lawrencek52/CPU1-NRF5340-uBlox-NORA/Bittele_Initial_DFM_Check_Report_8030233A1_20250904_LJK.xlsx

Sheet: DFM
 |  |  | Initial Design for Manufacturing Check Report |  |  |  |  |  |  |  | Form No:
 |  |  |  |  |  |  |  |  |  |  | BTL-DFM-001
Product # |  | Customer ID |  | Purchase Order | Quantity | Checked by |  |  | Audit by
 |  |  |  |  |  | Name | Date | Time(Hour) | Name | Date
8030233A1 |  | 503097 |  | None | 5 | Nate | 2025-09-04
Gerber File |  | R |  | X-Y Coordinate File | □ | Drill File | R | BOM check |  | Others
Note: If you have BOM change requests, please send the list of change details instead of sending an updated(new) BOM for quick turnaround. We will ignore the BOM in any zip file unless being requested.
Quiz# | Question Description |  |  |  |  | Illustration |  |  |  |  | Client Reply
DFM#1 | We found in the '*.gbrjob' file final board thickness is 1.0mm, but the order release file mentioned final board thickness is 1.2mm(47mil). You have specified the thickness of dielectric between layers, we will need to get it adjusted to meet our material sourcing and fabrication requirements. Suggestion A: Final board thickness as 1.0mm+/-10%, Allow us to adjust the stackup and our stack up in "Stackup A" is OK. Suggestion B: Final board thickness as 1.2mm(47mil)+/-10%, Allow us to adjust the stackup and our stack up in "Stackup B" is OK. |  |  |  |  |  |  |  |  |  | I initially started out targetingt 1mm thickness, however another supplier suggested 1.2mm would work for his in-stock materials. I prefer a 1mm thick PCB, please continue with 1.0mm. There are no impedance critical traces on this PCB, Any stackup that uses your standard materials is good. 1oz copper all layers is preferred. Use Stackup A.
DFM#2 | We found in the '*.gbrjob' file PCB size is 50.05x30.05mm, but the real PCB size is 50.0x30.0mm measured in Gerber file. Suggestion: Follow Gerber file for size of board. |  |  |  |  |  |  |  |  |  | I have no idea why KiCad, gives two different measurements. 50.0x30.0mm is the intended size.
DFM#3 | We found in the '*.gbrjob' file silkscreen green, but in the order release file, silkscreen white. Suggestion: Silkscreen white. |  |  |  |  |  |  |  |  |  | I prefer White.
DFM#4 | We found in the '*.gbrjob' file, it showed copper L7, L9, L11, but this is 6-layer board. and the layer sequence is not defined in Gerber. Please clarify. Suggestion: This is 6-layer board, we will build the layer sequence from top to bottom as shown in the picture on the right. |  |  |  |  |  |  |  |  |  | Correct this is a 6-layer board. I have no idea why KiCAD added the other layers. Prefered stacking order is to have PWR and GND on L2 and L5, with in1 and in2 between. However this is not critical.
DFM#5 | The copper area of the in1/in2 and pwr/gnd differs by more than 70%, which cause the stackup is asymmetrical, and it caused the board bow and twist exceed 0.75% and affect our assemble. In order to avoid this problem, we suggest we can add dummy copper pad in in1/in2, and keep the spacing from all existing copper 50mil. Suggestion : Allow us to add dummy copper pad in in1/in2. |  |  |  |  |  |  |  |  |  | Yes you can add dummy copper pad/pour in the inner layers to balance the copper. I suggested above moving the PWR and GND planes to L2 and L5, I think this will also balance the stresses. Either way is fine for me.
DFM#6 | The spacing is only 5.4mil between trace and NPTH hole. It is not enough for us. Suggestion: We can move the trace away from NPTH hole to gain 8mil spacing. (we can edit it on our side) |  |  |  |  |  |  |  |  |  | I will add this to my design rules for the next board. OK to move the track.
DFM#7 | Some via holes (0.2mm) with solder mask opening are close to the SMD pads as the picture shown for example, which will affect our assembling process, we would like to delete the solder mask opening of all via holes on both sides to smooth our assembling process. Suggestion A: Delete the solder mask opening for all via holes (0.2mm) on both sides, and only keep the solder mask opening of the via holes which on thermal pads. Suggestion B: Reducing the solder mask openings bigger than via holes 4mils(0.1mm) per side for all via holes (0.2mm). |  |  |  |  |  |  |  |  |  | Yes the board was a little congested and I ended up with Vias nibbling into pads. Please feel free to adjust the solder mask to make it work with your process. Solder mask is not critical to the design. Opening all vias, or only the vias with issues is OK either way. Do you need me to make this change?
DFM#8 | On the bottom side, the silkscreen is not match the pad, it looks more like top silkscreen layer, the components are on top side. Suggestion A: Ignore the bottom silkscreen layer, no silkscreen on bottom side of board. Suggestion B: Send us the new Gerber, put these silkscreen on top side (no mirror them), and if they are on or near pads, we can clip it from exposed pad, fuzzy and incomplete legends will be acceptable. |  |  |  |  |  |  |  |  |  | yes, this is correct. Reference designators on the backside of the PCB
DFM#9 | The spacing is only 11mil between non-plated hole and board edge, it may be broke after routing. Suggestion: The two holes break at board edge is acceptable. |  |  |  |  |  |  |  |  |  | Yes unfortunately the switches need to be close to the edge so that a human can press the buttons. If break occurs this is OK.

Sheet: 2nd
 |  |  | Initial Design for Manufacturing Check Report |  |  |  |  |  |  |  | Form No:
 |  |  |  |  |  |  |  |  |  |  | BTL-DFM-001
Product # |  | Customer ID |  | Purchase Order | Quantity | Checked by |  |  | Audit by
 |  |  |  |  |  | Name | Date | Time(Hour) | Name | Date
8030233A1 |  | 503097 |  | None | 5 | Nate
Gerber File |  | R |  | X-Y Coordinate File | □ | Drill File | R | BOM check |  | Others
Note: If you have BOM change requests, please send the list of change details instead of sending an updated(new) BOM for quick turnaround. We will ignore the BOM in any zip file unless being requested.
Quiz# | Question Description |  |  |  |  | Illustration |  |  |  |  | Client Reply
DFM#1
DFM#2
DFM#3

Sheet: 3rd
 |  |  | Initial Design for Manufacturing Check Report |  |  |  |  |  |  |  | Form No:
 |  |  |  |  |  |  |  |  |  |  | BTL-DFM-001
Product # |  | Customer ID |  | Purchase Order | Quantity | Checked by |  |  | Audit by
 |  |  |  |  |  | Name | Date | Time(Hour) | Name | Date
8030233A1 |  | 503097 |  | None | 5 | Nate
Gerber File |  | R |  | X-Y Coordinate File | □ | Drill File | R | BOM check |  | Others
Note: If you have BOM change requests, please send the list of change details instead of sending an updated(new) BOM for quick turnaround. We will ignore the BOM in any zip file unless being requested.
Quiz# | Question Description |  |  |  |  | Illustration |  |  |  |  | Client Reply
DFM#1
DFM#2
DFM#3

Sheet: Sheet1
资料相同-ODB | 2份PDF | 二维码 | 忽略IPC356 | 圆角-Slot | 成品板厚含绿油 | 板材 | TBD | TBD | TBD | TBD | TBD | ENIG
层顺序 | 图形一致 | Dummy PAD | 外形削铜 | 外层Hoz | 铜厚公差 | 线和PAD没连好 | TBD | TBD | VIP | Dam | 油墨入孔 | 虹吸
层压 | 共面影响 | ZK没有参考 | ZK间距不一致 | 参考铜皮不完整 | 同时满足2种阻抗 | TBD | 拼板 | 字符 | 白油桥 | Lot code | 不加stamp | 中国制造 | 小数点问题
资料相同 | The two zip files provided by you both including Gerber files, ODB++ files, and drawings. It is difficult for us to verify and compare them one by one to check if they are the same. Please confirm if they are identical, so I can use either one to produce the PCB. Suggestion: They are identical, we can use either one to produce the PCB. ########### 有解压的和未解压的 The given data include two files, one extracted and one not, containing a total of three Gerber files. It is difficult for us to check them one by one. Please confirm if they are the same, and we can use any one of the Gerber files. Suggestion: They are the same, and we can use any one of the Gerber files. ########### 只有ODB++ We were only provided with the ODB++ file. Since this type of file often contains some hidden errors, we prefer to use the more stable Gerber274x files." Suggestion: Provide us the Gerber274x file, ODB++ file just for reference.
层序 | The layer sequence is not defined in Gerber. Please clarify. Suggestion: We will build the layer sequence from top to bottom as shown in the picture on the right.
外形削铜 | ###### 铜皮无间隙 There is no clearance between copper plane and board edge on both side, it will be copper exposed after routing. we need 10mil clearance to avoid copper exposed issues. Suggestion: Shaving copper plane to gain 10mil clearance to avoid copper exposed issues on both side. ###### 铜皮间隙 The clearance is 2.5mil between copper plane and board edge on both side, it will be copper exposed after routing. we need 10mil clearance to avoid copper exposed issues. Suggestion: Shaving copper plane to gain 10mil clearance to avoid copper exposed issues on both side. ####### PAD到板边 There is no clearance between the edge of pad and board edge on both side, it will be copper exposed after routing. we need 10mil clearance to avoid copper exposed issues. Suggestion A: Shaving pads to gain 10mil clearance to avoid copper exposed issues on both side. Suggestion B: Follow Gerber file, copper exposed issue is acceptable on both side.
图形一致 | G1 and G2 layers are of the same copper pattern as the picture shown, please confirm they are the same. Suggestion: G1 layer as the same as G2 layer, just follow Gerber file.
虹吸 | ################## 只删除这些指出的孔 Some via holes( ) with solder mask opening are close to the SMD pads as the picture shown, which will affect our assembling process, we would like to delete the solder mask opening of these holes on both sides to smooth our assembling process. Suggestion A: Delete the solder mask openings of these via holes (indicated in the picture) on both sides. Suggestion B: Reducing the solder mask openings bigger than via holes 3mils(0.08mm) per side for these holes (indicated in the picture). ################## 删除所有的孔 Some via holes( ) with solder mask opening are close to the SMD pads as the picture shown for example, which will affect our assembling process, we would like to delete the solder mask opening of all via holes on both sides to smooth our assembling process. Suggestion A: Delete the solder mask opening for all via holes( ) on both sides, and only keep the solder mask opening of the via holes which on thermal pads. （注意检查是否有散热盘） Suggestion B: Reducing the solder mask openings bigger than via holes 3mils(0.08mm) per side for all via holes ( ).
油墨入孔 | ########### 油墨入孔 如果是 喷锡板 只给一个加开窗的建议 As the picture shown, these 25mils holes without solder mask opening on both side, the solder mask ink may flow into the hole, causing the solder ball to be trapped in the hole and unable to come out. However, during our assembling process, the trapped solder ball in the hole may pop out, leading to unnecessary short circuits. Suggestion: Adding solder mask opening bigger than hole 4mil per side for these holes on both side to avoid this risk. ############### As the picture shown, please confirm these big holes (25mil, 35mil and 50mil) are via holes or not? and due to they are without solder mask opening on both side, the solder mask ink will flow into the hole is acceptable or not? Suggestion A: Follow Gerber, and solder mask ink flow into these holes are acceptable. Suggestion B: Adding solder mask opening bigger than hole 4mil per side for these holes on both side to avoid solder mask ink flow into hole.
桥 | As shown in the picture , you have designed solder mask dam between SMD pads, but the spacing is 5.7mils between those pads, it hard to keep the solder mask dam for us, we need the minimum 7mils spacing for 1oz copper weight. If there is no solder mask dam between pads, it is easy for solder bridge issues to occur between pads during assembly, to help the assembly process, we are wondering if we can shave SMD pads a little or use solder mask define pad to keep the solder mask dam between the pads. Suggestion A: Shaving those SMD pads to gain 7mils spacing between SMD pads is acceptable. Suggestion B: Enlarge the copper pads and reduce the solder mask opening in such places to build the solder mask dam. And finally, the SMD pads will be covered by solder mask a little, but the exposed area will be almost the same as the original pad size. ########## 削中间大PAD You have designed solder mask dam between SMD pads and the big central pad, but the spacing is 5.5mils between those pads, it hard to keep the solder mask dam for us, we need the minimum 7mils spacing for 1oz copper. Suggestion: Shaving the big central pad to gain 7mils spacing to SMD pads is acceptable. ########## 削角落的PAD You have designed solder mask dam between SMD pads, but at the corners the spacing is only 7.2mil between SMD pads, we need the minimum 8mils spacing for blue solder mask. Suggestion: Shaving the SMD pads a little at the corners to gain 8mils spacing to keep the solder mask dam is acceptable.
层压 | ################### 层压结构与客户是一样的， 只是客户的厚度为理论厚度 You have specified the thickness of dielectric between layers, the dielectric thickness in your stackup seems to be the theoretical thickness, while the dielectric thickness in our suggested stackup is the actual thickness after lamination, so there will be a slight difference. In fact, our suggested stackup is the same as the one you provided. Suggestion: Allow our stack up in "Stackup II" . ################### 层压结构 You have specified the thickness of dielectric between layers, we will need to get it adjusted to meet our material sourcing and fabrication requirements. Suggestion: Allow us to adjust the stackup and our stack up in "Stackup II" is OK. ################### 只有阻抗没有指定层压结构 Due to the board with impedance control, we will design the layer stackup to meet our material sourcing and adjust the width of transmission trace a little to meet the impedance requirements. Suggestion: The stackup as "Stackup II" and adjust the transmission traces as "Figure III" are OK. ####################有阻抗 且 指定层压结构 You have specified the thickness of dielectric between layers, we will need to get it adjusted to meet our material sourcing and to meet the impedance requirements. Suggestion: Adjust the stackup as "Stackup II" and adjust the impedance traces as "Figure III" are OK.
字符 | Some legends are onto or near pad as the picture shown (just to show a few things), and it is not easy to move it away. Suggestion: Clipping any legends from all exposed copper, fuzzy and incomplete legends will be acceptable. ##################### Some legends height is only 20mil, when the legends height smaller than 30mil in Gerber, it will be hard for us to print them clearly, and it is very hard for us to enlarge the legends height from 20mil to 30mil, and some legends are on and near pads. Suggestion: The legends height keep the same as Gerber file, and clip the legends from all exposed copper, fuzzy and incomplete legends will be acceptable.
板材 | You required the material is FR406 in "Fab Files 41-0096-002.PDF", but in order release file mention materials FR4(TG150). And the point is that FR406 (ISOLA) is not a material in common usage in our company. Suggestion: Use our standard FR4(Tg150) material for this board per IPC 4101. Suggestion: Use our standard FR4(Tg170) material for this board per IPC 4101. ############# 忽略DK Note#7 required the dielectric for prepreg and core layers to be 4.3+/-0.2, it is hard to test this for PCB manufacturer. Suggestion: The dielectric of prepreg and core are depend on the material, ignore the requirement of note#7.
二维码 Data matrix | In the order release file, note2 CFT required applying data matrix seriallzation using silkscreen printing onto board, but there is no format of serial number, we are not sure if we can started from 001, and incrementing. If we print the serial number in the silkscreen layer, it will be extra cost, please take note that, if use a sticker to stick the serial number after assemble process, there will be no extra cost. Suggestion A：The serial number is started from 001, and incrementing, use a sticker to stick the serial number after assemble process Suggestion B：The serial number is started from 001, and incrementing, print the serial number in the silkscreen layer, it will be extra cost.
忽略IPC | There are two shorted issues after comparing with netlist file. Suggestion: Ignore the shorted issues, and extract the netlist from the Gerber file to test the physical board is OK. Note#15 required tested for opens and shorts against net list, but we did not get the useful netlist file, there is a *.NET file in the given data, but this is not IPC-356 format, our CAM system can recognize IPC-356 file only. Suggestion: Skip Note#15, extract the netlist from the Gerber file to test the physical board is OK.
圆角 Slot | ############# 内角 We found some internal corners with no radius as the picture shown, due to the board method by routing, and the minimum tool is 40mils, this is means that any internal corner will have a minimum radius of 20mils. Suggestion: Round off all internal corners with a minimum radius of 20mils as "Picture II" is acceptable. ######## Full rounded ends ######### For the 6 slots (1.0x3.23mm), you rounded the four corners with radius 0.4mm, we are wondering if we make them with full rounded ends for drilling process. Suggestion: Full rounded ends for the 6 slots as the "Picture II" is OK. ############# 方孔圆角 The one of drill file name is "RectHoles", but it is not rectangle shape in the NC drill file, they are full rounded ends. Suggestion: The three slots with full rounded ends is OK, just follow NC drill file. ############# 方孔圆角 The T6 and T13 hole type is "Rectangle", but it is not rectangle shape in the NC drill file, they are full rounded ends. Suggestion: The three slots with full rounded ends is OK, just follow NC drill file. ########### 最小 slot 0.5mm The two plated slots width is 0.4mm only (length is 0.9mm), usually, we will oversize the drill 0.1mm to account for the thickness of the plating, so, we have to use 0.5mm drill bit for them, but the minimum drill bit is 0.6mm for slot in PCB industry, so we just can make 0.5mm plated slot. Suggestion: Finished size as 0.5x1.0mm for the 2 slots is OK. The two slots size is 0.45x0.65mm, we have to use 0.55mm slot dr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
VIP | ######### 缩小孔 As the picture shown, we found one 12mils hole on SMD pad, if follow Gerber to build, there will be a risk of leaking tin when assembling and cause a bad effect, so we would like to reduce this via hole size from 12mils to 8mils to reduce the risk. Suggestion: Reduce the via hole size from 12mils to 8mils to reduce the risk. ########## 移孔 There is no via-in-pad requirement for the board, but we found three 13mils via holes in the pad as the picture shown on top side. Is there any way to move the three via holes away SMD pads on your side to avoid via-in-pad design to reduce the cost and lead time. Suggestion: Update the Gerber to us with no via-in-pad design. ############### 做VIP As the picture show, we found some via(0.21mm, 0.35mm) holes in the SMD pads, but there is no via-in-pad requirement in the given data. Suggestion: Do via-in-pad for this board, fill these vias which on the SMD pads with non-conductive resin and plated over, we may requote for via in pad process.
拼板 | You have designed the panel drawing, but this is a turnkey order ( this board will be assembled by our side), so we are not sure if we need to ship it as the single unit board or panel after assembling. Suggestion: Allow us to do panel by ourselves （no confirmation needed), ship it as single unit board after assembling. ######### 套板 ########## 2种不同的板 There are two different boards in the given data, due to this is a turnkey order ( this board will be assembled by our side). Please confirm whether we need to deliver in single or deliver as panels after assembling. Suggestion: We panelize both boards onto one panel by ourselves for assembling, and deliver PCB as single units after assembling. ###### 套板, 确认出板数 There are two different boards per your design, therefore, please confirm the quantity, is it 500 pcs per each board? Suggestion: Yes, 500 pcs per each board. ###### 套板, 确认单板尺寸
共面影响 | These transmission traces to the copper plane spacing is only 5.24mil, it will affect the impedance value about 7 ohms, we advise to trim the copper plane to keep 10mil spacing to impedance trace. Suggestion: Trim the copper plane to keep 10mil spacing to transmission traces (see the "Figure II").
成品板厚含绿油 | Since you requested the PCB total thickness of 1.6mm without considering the copper and solder mask, this makes it very inconvenient for our company to inspect the final board thickness before shipment, as it is impossible to find an area without solder mask after the solder mask process to measure the thickness. Suggestion: To facilitate our final inspection of the board thickness, the total thickness of 1.6mm should include the copper foil, solder mask, surface finish, etc."
Dummy PAD | The copper area of the L2 and L5 differs by more than 40%, which cause the stackup is asymmetrical, and it caused the board bow and twist exceed 0.75% and affect our assemble. In order to avoid this problem, we suggest we can add dummy copper pad in L2, and keep the spacing from all existing copper 50mil. Suggestion A: Allow us to add dummy copper pad in L2. Suggestion B: Release the boards’ bow and twist not exceed 1.0%.
2份PDF | There are two " **** " files in the given data, it is difficult to verify whether these two PDF files are the same. Suggestion: They are the same, and we can use any one of them.
白油桥 | The distance is less than 17mil between two copper pads(these pads spacing is only 12.2mil), it is so narrow that we can not keep the silkscreen bridges between pads. Suggestion: Allow us to cancel the silkscreen bridges if the distance is less than 17mil between two copper pads.
Lot code | ####### lot code There is no detailed description of how to add the lot code. Could you please confirm if we can ignore the lot code, only add date code in the board. Suggestion: Ignore the lot code, only add date code on the silkscreen layer. ####### lot number There is no detailed description of how to add the lot number. Could you please confirm if we can ignore the lot number, only add date code in the board. Suggestion: Ignore the lot number, only add date code on the silkscreen layer.
不加stamp | #20 required to add ET stamp, but the board is too small, there is no available area to add it. Suggestion: Do 100% full electrical testing, no need to add the ET stamp on the board.
中国制造 | There are words of "MADE IN U.S.A" on the bottom copper layer, if we follow the gerber to keep "MADE IN U.S.A", this board may be hold up by the customs when we ship this board. Suggestion A: Delete ""MADE IN U.S.A" on bottom copper layer. Suggestion B: Change it to "DESIGNED IN U.S.A" on bottom silkscreen layer.
IPC-4552 | #层压上的表面处理厚度只是用于说明 The surface finish thickness 0.16mil showed in the layer stack legend, the thickness is not match IPC-4552. Suggestion: The surface finish thickness in layer stack legend for illustration only, we can ignore it. ########## The gold thickness you require exceeds the IPC-4552 standard. Suggestion: The gold thickness be in accordance with IPC-4552.
ZK没有参考 | We noticed two transmission line groups on layer 1 have no shielding copper on the reference layer (layer 2), the impedance will mismatch due to the broken reference plane. Suggestion: The impedance mismatch for the transmission lines is acceptable.
ZK间距不一致 | You required the transmission lines 8.8mil width and 7.59mil separation on top layer, but in the Gerber file various separation have been measured as the picture shown, with a deviation range between 6.17mil and 7.8mil. Suggestion: The deviation separation follow Gerber file, and we use 7.59mil separation to calculate the impedance.
没有足够的参考铜皮 | Some transmission lines(0.0751mm) on G2 and G3 did not have enough coverage on the reference layer as the picture shown, the impedance value will be inaccurate for these transmission lines. Suggestion: Inaccurate impedance value is acceptable for these transmission lines where there is no enough coverage on the reference layer.
同时满足2种阻抗 | These 8/6mil pair traces in the gerber file as below picture shown, we can't meet the single impedance 50ohm and differential 100ohm at the same time, if adjust the trace width/spacing: 8/6mil to 7.2/6.8mil to meet the differential 100ohm, the single impendace will be 64ohm, can't meet 50ohm. Suggestion : Ignore the single impendace 50 ohm requirement, only control differential impedance 100ohm, adjust the trace width/spacing from 8/6mil to 7.2/6.8mil.
外层Hoz | You required 0.5oz external layers, please confirm we can starting with 0.5oz copper weight, and the final copper thickness minimum 33.4um per IPC-6012. Suggestion: We starting with 0.5oz copper weight, and the final copper thickness minimum 33.4um per IPC-6012.
铜厚公差 | You required the inner copper thickness 0.03556+/-0.00254mm, outer copper thickness 0.07112+/-0.00508mm on the layer stackup, the tolerance is very narrow for us. Suggestion: For inner layers, we starting with 1oz(35um) copper weight, and the final copper thickness minimum 24.9um per IPC-6012; for outer layers, we starting with 1oz(35um) copper weight, and the final copper thickness 2oz per IPC-6012( 61.7um Min.).
线和PAD没有连接好 | The traces just touched the pad a little on bottom side, please confirm they are in the same net and should be connected. Suggestion: Extend the traces a little bit to ensure a solid connection.
小数点 | ############# 分孔图 Since the hole size in the drill table is rounded to one decimal place, it results in a discrepancy between the hole size and the NC drill file. Suggestion: Hole size just follow the NC drill file. ############# 阻抗线 In the transmission line structure table, the 0.2mm/0.2mm (width/gap) lines are transmission lines, but the 0.2mm lines don't like a transmission line, whereas the 0.152mm lines (with 0.152mm gap) look more like a transmission line. I think this is probably due to the fact that the line width/gap values are rounded to one decimal place. Suggestion: The 0.152mm/0.152mm (6mil/6mil) lines are transmission line for the three layers.
