lawrencek52/CPU1-NRF5340-uBlox-NORA/T-6C2W877461A-5sets-250918+Sensor1(2025-09-18).xls

PCBWay Bom Quotation, Product No.:T-6C2W877461A
Item # | *Designator | *Qty | Manufacturer | *Mfg Part # | Description / Value | Vendor Part # | *Package/Footprint | Your Instructions / Notes | *Unit Price(5 sets) | *Total | *Delivery Time | *PCBWay Note | Customer Reply | PCBWay Update
1 | BT1 | 1 | Keystone Electronics | 2997 | BAT_LR44_2997『 』Battery Retainer Coin, 11.6mm 1 Cell PC Pin | 36-2997-ND |  |  | $0.542 | $2.710
2 | C7 | 1 | Samsung Electro-Mechanics | CL21A476MQYNNNE | 47uF, 6.3V『 』47 µF ±20% 6.3V Ceramic Capacitor X5R 0805 (2012 Metric) | 1276-1852-1-ND |  |  | $0.158 | $0.790
3 | C9 | 1 | Samsung Electro-Mechanics | CL21A106KOQNNNG | 10uF『 』10 µF ±10% 16V Ceramic Capacitor X5R 0805 (2012 Metric) | 1276-6455-1-ND |  |  | $0.158 | $0.790
4 | C21 | 1 | Samsung Electro-Mechanics | CL05C2R2CB51PNC | 2.2pF『 』2.2 pF ±0.25pF 50V Ceramic Capacitor C0G, NP0 0402 (1005 Metric) | 1276-CL05C2R2CB51PNCCT-ND |  | DNP |  |  |  | [DNP] components[DNP不要贴];
5 | C22 | 1 | Samsung Electro-Mechanics | CL05C2R2CB51PNC | 2.2PF『 』2.2 pF ±0.25pF 50V Ceramic Capacitor C0G, NP0 0402 (1005 Metric) | 1276-CL05C2R2CB51PNCCT-ND |  | DNP |  |  |  | [DNP] components[DNP不要贴];
6 | C23 | 1 | Samsung Electro-Mechanics | CL05A225MQ5NNNC | 2.2uF『 』2.2 µF ±20% 6.3V Ceramic Capacitor X5R 0402 (1005 Metric) | 1276-1469-1-ND |  | DNP |  |  |  | [DNP] components[DNP不要贴];
7 | C24 | 1 | Samsung Electro-Mechanics | CL05B224KQ5NNWC | 220nF『 』0.22 µF ±10% 6.3V Ceramic Capacitor X7R 0402 (1005 Metric) | 1276-1511-1-ND |  |  | $0.126 | $0.630
8 | C1 C2 C3 C4 C8 C11 C15 C17 C18 C19 C20 | 11 | Samsung Electro-Mechanics | CL05B104KQ5NNNC | 0.1uF『 』0.1 µF ±10% 6.3V Ceramic Capacitor X7R 0402 (1005 Metric) | 1276-1511-1-ND |  |  | $0.039 | $2.145
9 | C10 C14 | 2 | Samsung Electro-Mechanics | CL05A475KQ5NRNC | 4.7uF『 』4.7 µF ±10% 6.3V Ceramic Capacitor X5R 0402 (1005 Metric) | 1276-1481-1-ND |  |  | $0.076 | $0.760
10 | C12 C16 | 2 | Samsung Electro-Mechanics | CL05C330JB5NNNC | 33pF『 』33 pF ±5% 50V Ceramic Capacitor C0G, NP0 0402 (1005 Metric) | 1276-1272-1-ND |  |  | $0.076 | $0.760
11 | C5 C6 C13 | 3 | Samsung Electro-Mechanics | CL05A105KQ5NNNC | 1uF『 』1 µF ±10% 6.3V Ceramic Capacitor X5R 0402 (1005 Metric) | 1276-1010-1-ND |  |  | $0.059 | $0.885
12 | D1 | 1 | onsemi | ESD9B3.3ST5G | ESD9B3.3ST5G『 』ESD protection diode, 3.3Vrwm, SOD-923 | ESD9B3.3ST5GOSCT-ND |  |  | $0.108 | $0.540 | 7-10 Workdays
13 | D4 | 1 | MCC (Micro Commercial Components) | 1N4148WL2-TP | 1N4148WL2-TP『 』75V 0.15A Fast switching Diode, SOD-523 | 1N4148WL2-TPMSCT-ND |  |  | $0.042 | $0.210
14 | D2 D3 | 2 | QT Brightek (QTB) | QBLP595-R5 | A-SP136R6C-C01-3T RED『 』-40℃~+85℃ 120° 2V 57mcd 5mA 60mW 617.5nm~629.5nm 632nm Red Water Clear op View Mount 0402 LED Indication - Discrete ROHS | 1516-QBLP595-R5CT-ND |  |  | $0.174 | $1.740 | 7-10 Workdays | The quoted part number is [QBLP595-R5], not [A-SP136R6C-C01-3T] as specified in description.Please confirm.
15 | J1 | 1 | TE Connectivity Linx | CONMHF1-SMD-G-T | CONMHF1-SMD-G-T『 』U.FL (UMCC) Connector Jack, Male Pin 50 Ohms Surface Mount Solder | 343-CONMHF1-SMD-G-TCT-ND |  |  | $0.365 | $1.825 | 7-10 Workdays
16 | J2 | 1 | Hirose Electric Co Ltd | FH34SRJ-12S-0.5SH(50) | FH34SRJ-12S-0.5SH_50_『 』12 Position FFC, FPC Connector Contacts, Top and Bottom 0.020 (0.50mm) Surface Mount, Right Angle | 26-FH34SRJ-12S-0.5SH(50)CT-ND |  |  | $0.483 | $2.415
17 | J4 | 1 | Samtec Inc. | FTSH-105-01-L-D | Conn_02x05_Odd_Even『 』Generic connector, double row, 02x05, odd/even pin numbering scheme (row 1 odd numbers, row 2 even numbers), script generated (kicad-library-utils/schlib/autogen/connector/) | SAM10499-ND |  | DNP |  |  |  | [DNP] components[DNP不要贴];
18 | Q3 | 1 | Diodes Incorporated | DMP56D0UFB-7B | DMP56D0UFB-7B『 』P-Channel 50 V 200mA (Ta) 425mW (Ta) Surface Mount X1-DFN1006-3 | DMP56D0UFB-7BDICT-ND |  |  | $0.409 | $2.045
19 | Q4 | 1 | Nexperia USA Inc. | BCM856BS,115 | BCM856BS_115『 』Bipolar (BJT) Transistor Array 2 PNP (Dual) Matched Pair 65V 100mA 175MHz 300mW Surface Mount 6-TSSOP | 1727-5424-1-ND |  | DNP |  |  |  | [DNP] components[DNP不要贴];
20 | Q1 Q2 Q5 | 3 | MCC (Micro Commercial Components) | MC3541KL3-TP | MC3541KL3『 』N-Channel 30 V 300mA (Ta) 690mW (Tj) Surface Mount DFN1006-3 | 353-MC3541KL3-TPCT-ND |  |  | $0.124 | $1.860 | 7-10 Workdays
21 | R1 | 1 | YAGEO | RC0402FR-075K49P | 5490『 』-55℃~+125℃ 100mW 5490Ω 50V Thick Film Resistor ±1% ±100ppm/℃ 0402 Chip Resistor - Surface Mount ROHS | 13-RC0402FR-075K49PCT-ND |  |  | $0.126 | $0.630 |  | The correct power rating for the listed Part Number [RC0402FR-075K49P] is indeed [0.0625W], not [100mW].Please confirm.
22 | R2 | 1 | YAGEO | RC0402FR-0763K4L | 63.4k『 』-55℃~+125℃ 100mW 63.4kΩ 50V Thick Film Resistor ±1% ±100ppm/℃ 0402 Chip Resistor - Surface Mount ROHS | YAG3204CT-ND |  |  | $0.032 | $0.160 |  | The correct power rating for the listed Part Number [RC0402FR-0763K4L] is indeed [62.5mW], not [100mW].Please confirm.
23 | R9 | 1 | YAGEO | RC0402JR-100RL | 0『 』0 Ohms Jumper Chip Resistor 0402 (1005 Metric) Moisture Resistant Thick Film | 13-RC0402JR-100RLCT-ND |  |  | $0.032 | $0.160
24 | R14 | 1 | YAGEO | RC0402JR-071KL | 1K『 』1 kOhms ±5% 0.063W, 1/16W Chip Resistor 0402 (1005 Metric) Moisture Resistant Thick Film | 311-1.0KJRCT-ND |  | DNP |  |  |  | [DNP] components[DNP不要贴];
25 | R15 | 1 | YAGEO | RC0402JR-13330RL | 330『 』330 Ohms ±5% 0.063W, 1/16W Chip Resistor 0402 (1005 Metric) Thick Film | 13-RC0402JR-13330RLCT-ND |  | DNP |  |  |  | [DNP] components[DNP不要贴];
26 | R11 R18 | 2 | YAGEO | RC0402JR-0722RL | 22『 』22 Ohms ±5% 0.063W, 1/16W Chip Resistor 0402 (1005 Metric) Moisture Resistant Thick Film | 311-22JRCT-ND |  | DNP |  |  |  | [DNP] components[DNP不要贴];
27 | R16 R21 | 2 | YAGEO | RC0402FR-07294RL | 294『 』294 Ohms ±1% 0.063W, 1/16W Chip Resistor 0402 (1005 Metric) Moisture Resistant Thick Film | YAG3093CT-ND |  |  | $0.019 | $0.190
28 | R3 R4 R10 | 3 | YAGEO | RC0402JR-1310KL | 10k『 』10 kOhms ±5% 0.063W, 1/16W Chip Resistor 0402 (1005 Metric) Moisture Resistant Thick Film | 13-RC0402JR-1310KLCT-ND |  |  | $0.015 | $0.225
29 | R5 R6 R8 R12 R13 R22 | 6 | YAGEO | RC0402FR-10100KL | 100k『 』100 kOhms ±1% 0.063W, 1/16W Chip Resistor 0402 (1005 Metric) Moisture Resistant Thick Film | 13-RC0402FR-10100KLCT-ND |  | DNP |  |  |  | [DNP] components[DNP不要贴];
30 | R7 R17 R19 | 3 | YAGEO | RC0402JR-0722KL | 22k『 』22 kOhms ±5% 0.063W, 1/16W Chip Resistor 0402 (1005 Metric) Moisture Resistant Thick Film | 311-22KJRCT-ND |  |  | $0.015 | $0.225
31 | U1 | 1 | Quectel | LC26GABMD | LC26GABMD『 』- RF Receiver BeiDou, Galileo, GLONASS, GNSS, GPS, QZSS 1.561GHz, 1.575GHz, 1.598GHz, 1.605GHz -166dBm 921.6Mbps 24-LCC (16x12.2) | 2958-LC26GABMDCT-ND |  |  | $6.300 | $31.500
32 | U2 | 1 | Lite-On Inc. | LTR-303ALS-01 | LTR-303ALS-01『 』ambient light sensor, i2c interface, 0.01 to 64k lux, 2.4-3.6V | 160-2161-1-ND |  |  | $0.483 | $2.415
33 | U3 | 1 | Bosch Sensortec | BMI270 | BMI270『 』Accelerometer, Gyroscope, 6 Axis Sensor I2C, SPI Output | 828-1091-1-ND |  |  | $2.254 | $11.270
34 | U4 | 1 | Bosch Sensortec | BMP581 | BMP581『 』Pressure Sensor 4.35PSI ~ 18.13PSI (30kPa ~ 125kPa) Absolute 10-WFLGA | 828-BMP581CT-ND |  |  | $3.019 | $15.095
35 | U6 | 1 | Texas Instruments | HDC2022DEPR | HDC2022DEPR『 』Humidity, Temperature 20 ~ 80% RH I2C ±3% RH 6 s Surface Mount | 296-HDC2022DEPRCT-ND |  |  | $4.717 | $23.585
36 | U7 | 1 | Texas Instruments | TPS2116DRLR | TPS2116DRL『 』2 Channnels Power Mux with Manual and Priority Switchover, 1.6-5.5V Input Voltage, 2.5A Output Current, Ron 40 mOhm, SOT-583-8 | 296-TPS2116DRLRCT-ND |  |  | $0.725 | $3.625
37 | U8 | 1 | Vishay Siliconix | SIP32431DR3-T1GE3 | SiP32431DR3『 』10 pA, Ultra Low Leakage and Quiescent Current, Load Switch with Reverse Blocking, High Enable, SC-70-6 | SIP32431DR3-T1GE3CT-ND |  |  | $0.712 | $3.560
38 | U9 | 1 | STMicroelectronics | IIS2MDCTR | IIS2MDC『 』3 Axis Magnetometer | 497-17728-1-ND |  |  | $3.889 | $19.445 | 7-10 Workdays
39 | U10 | 1 | NXP USA Inc. | PCAL6408ABSHP | PCAL6408ABS『 』8-bit I2C-bus/SMBus I/O expander, 100 / 400 kHz (standard / fast-mode), interrupt output, 1.65 - 5.5V supply, VQFN-16 | 568-11578-1-ND |  |  | $2.053 | $10.265
 |  |  |  |  |  |  |  |  | Component Cost | $142.45
 |  |  |  |  |  |  |  |  | Assembly Cost
 |  |  |  |  |  |  |  |  | PCB Cost
 |  |  |  |  |  |  |  |  | V0 Member 0% off | $0.00
 |  |  |  |  |  |  |  |  | All Total 5 Sets | $142.45
