lawrencek52/CPU1-NRF5340-uBlox-NORA/CPU1-NRF5340-uBlox-NORA.pdf

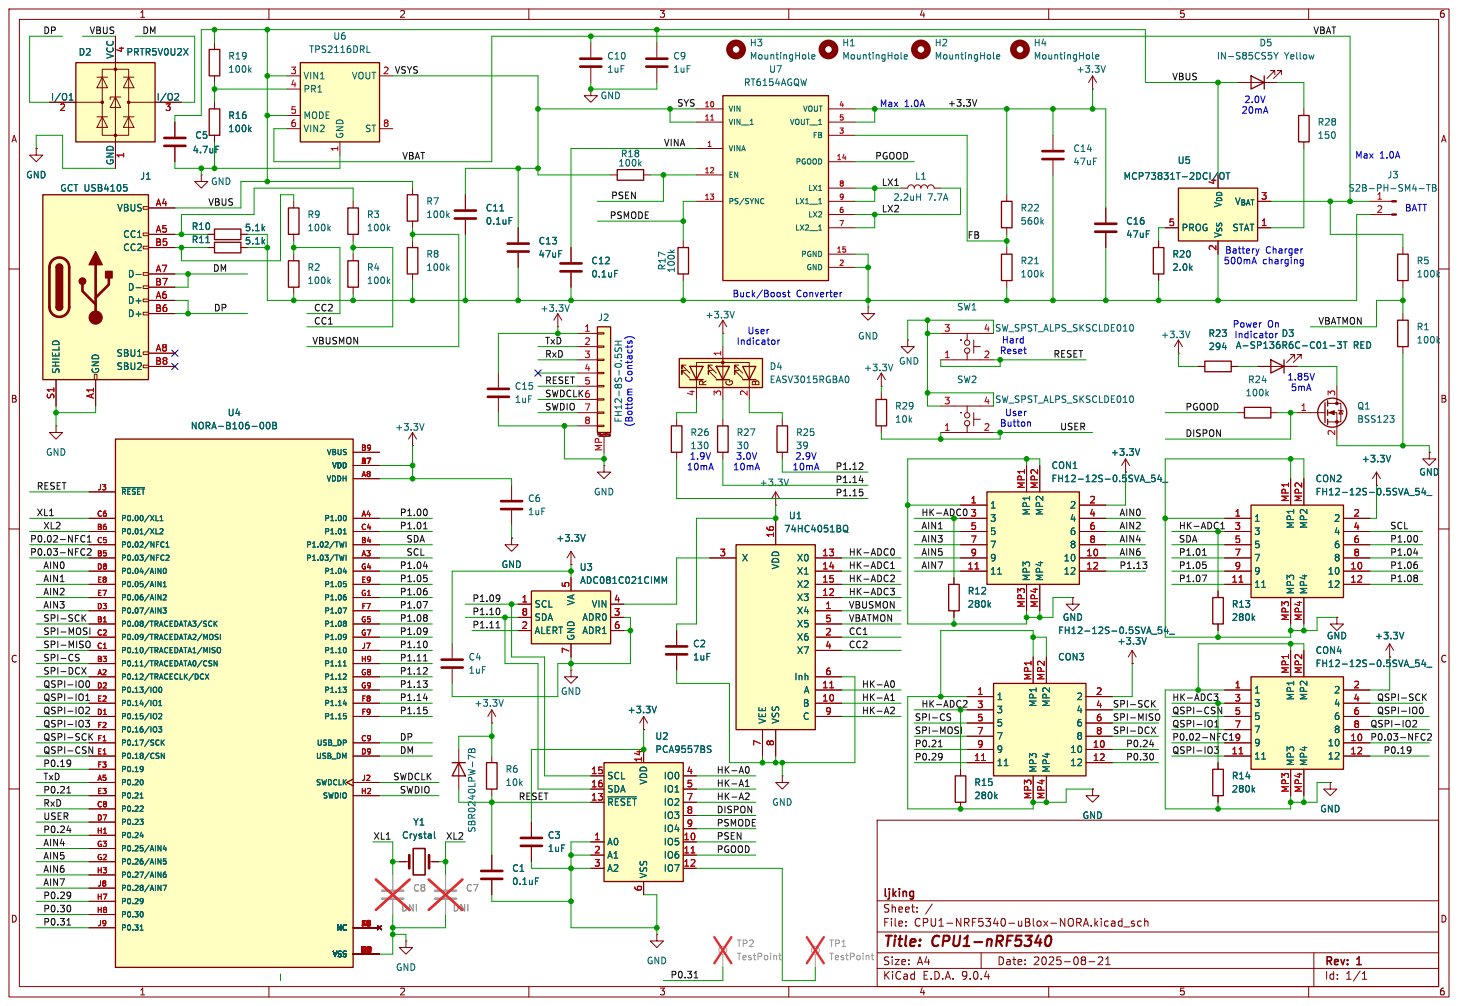
[picture p1: page 1]

ljking
File: CPU1-NRF5340-uBlox-NORA.kicad_sch Sheet: /
Id: 1/1 Title: CPU1-nRF5340
