lawrencek52/CPU1-NRF5340-uBlox-NORA/CPU1-NRF5340-uBlox-NORA.kicad_pcb

## KiCad design CPU1-NRF5340-uBlox-NORA.kicad_pcb (2025-09-19)

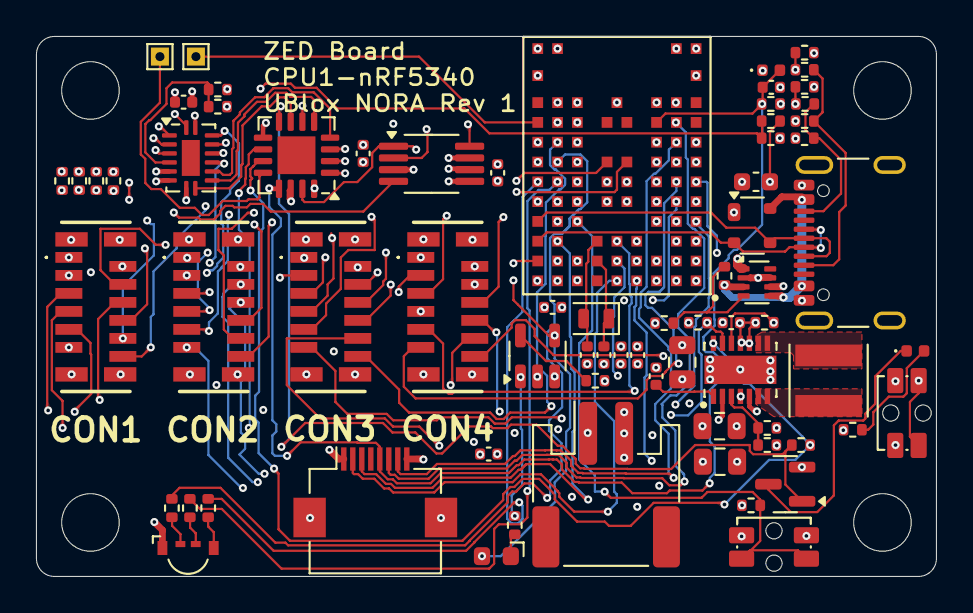
[picture p2: board CPU1-NRF5340-uBlox-NORA.kicad_pcb from above]

Board: 6 copper layers, 50.0 x 30.0 mm, 75 parts (0 on the bottom side), 90 nets.

Parts:
C1, C11, C12: 0.1uF; C_0402_1005Metric
C2, C3, C4, C6, C9, C10, C15: 1uF; C_0402_1005Metric
C5: 4.7uF; C_0603_1608Metric
C7, C8: DNI; C_0402_1005Metric
C13, C14, C16: 47uF; C_0805_2012Metric
CON1, CON2, CON3, CON4: FH12-12S-0.5SVA_54_; FH1212S05SVA54
D1: SBR0240LPW-7B; D_0402_1005Metric
D2: PRTR5V0U2X; SOT-143
D3: A-SP136R6C-C01-3T RED; LED_0402_1005Metric
D4: EASV3015RGBA0; LED_RGB_Everlight_EASV3015RGBA0_Horizontal
D5: IN-S85CS5Y Yellow; LED_Kingbright_APA1606_1.6x0.6mm_Horizontal
H1, H2, H3, H4: MountingHole; MountingHole_3.2mm_M3_ISO14580
J1: GCT USB4105; USB_C_Receptacle_GCT_USB4105-xx-A_16P_TopMnt_Horizontal
J2: FH12-8S-0.5SH; Hirose_FH12-8S-0.5SH_1x08-1MP_P0.50mm_Horizontal
J3: S2B-PH-SM4-TB; JST_PH_S2B-PH-SM4-TB_1x02-1MP_P2.00mm_Horizontal
L1: 2.2uH 7.7A; IND_NRS4018T2R2MDGJ
Q1: BSS123; SOT-23
R1, R2, R3, R4, R5, R7, R8, R9, R16, R17, R18, R19, R21, R24: 100k; R_0402_1005Metric
R6, R29: 10k; R_0402_1005Metric
R10, R11: 5.1k; R_0402_1005Metric
R12, R13, R14, R15: 280k; R_0402_1005Metric
R20: 2.0k; R_0402_1005Metric
R22: 560k; R_0402_1005Metric
R23: 294; R_0402_1005Metric
R25: 39; R_0402_1005Metric
R26: 130; R_0402_1005Metric
R27: 30; R_0402_1005Metric
R28: 150; R_0402_1005Metric
SW1, SW2: SW_SPST_ALPS_SKSCLDE010
TP1, TP2: TestPoint; TestPoint_THTPad_1.0x1.0mm_Drill0.5mm
U1: 74HC4051BQ; DHVQFN-16-1EP_2.5x3.5mm_P0.5mm_EP1x2mm
U2: PCA9557BS; Texas_RGV0016A_VQFN-16-1EP_4x4mm_P0.65mm_EP2.1x2.1mm
U3: ADC081C021CIMM; MSOP-8_3x3mm_P0.65mm
U4: NORA-B106-00B; XCVR_NORA-B106-00B
U5: MCP73831T-2DCI/OT; SOT-23-5
U6: TPS2116DRL; SOT-583-8
U7: RT6154AGQW; VREG_RT6154AGQW
Y1: Crystal; Crystal_SMD_2012-2Pin_2.0x1.2mm

Connections:
+3.3V: C2.1, C3.1, C4.1, C6.1, C14.1, C15.1, C16.1, CON1.2, CON2.2, CON3.2, CON4.2, D1.1 (K), D4.1 (A), J2.1, R6.1, R22.1, R23.2, R29.1, U1.16 (VDD), U2.14 (VDD), U3.5 (VA), U4.A7 (VDD), U4.A8 (VDDH), U4.B7 (VDD), U7.4 (VOUT), U7.5 (VOUT__1)
/AIN0: CON1.4, U4.D8 (P0.04/AIN0)
/AIN1: CON1.5, U4.E8 (P0.05/AIN1)
/AIN2: CON1.6, U4.E7 (P0.06/AIN2)
/AIN3: CON1.7, U4.D3 (P0.07/AIN3)
/AIN4: CON1.8, U4.G3 (P0.25/AIN4)
/AIN5: CON1.9, U4.G2 (P0.26/AIN5)
/AIN6: CON1.10, U4.H3 (P0.27/AIN6)
/AIN7: CON1.11, U4.J8 (P0.28/AIN7)
/CC1: R3.2, R4.1, U1.2 (X6)
/CC2: R2.1, R9.2, U1.4 (X7)
/DISPON: Q1.1 (G), R24.1, U2.8 (IO3)
/DM: D2.3 (I/O2), J1.A7 (D-), J1.B7 (D-), U4.D9 (USB_DM)
/DP: D2.2 (I/O1), J1.A6 (D+), J1.B6 (D+), U4.C9 (USB_DP)
/FB: R21.1, R22.2, U7.3 (FB)
/HK-A0: U1.11 (A), U2.4 (IO0)
/HK-A1: U1.10 (B), U2.5 (IO1)
/HK-A2: U1.9 (C), U2.7 (IO2)
/HK-ADC0: CON1.3, R12.1, U1.13 (X0)
/HK-ADC1: CON2.3, R13.1, U1.14 (X1)
/HK-ADC2: CON3.3, R15.1, U1.15 (X2)
/HK-ADC3: CON4.3, R14.1, U1.12 (X3)
/LX1: L1.1, U7.8 (LX1), U7.9 (LX1__1)
/LX2: L1.2, U7.6 (LX2), U7.7 (LX2__1)
/P0.02-NFC1: CON4.9, U4.C5 (P0.02/NFC1)
/P0.03-NFC2: CON4.10, U4.B5 (P0.03/NFC2)
/P0.19: CON4.12, U4.F3 (P0.19)
/P0.21: CON3.9, U4.E3 (P0.21)
/P0.24: CON3.10, U4.H1 (P0.24)
/P0.29: CON3.11, U4.H7 (P0.29)
/P0.30: CON3.12, U4.H8 (P0.30)
/P0.31: TP2.1, U4.J9 (P0.31)
/P1.00: CON2.6, U4.A4 (P1.00)
/P1.01: CON2.7, U4.C4 (P1.01)
/P1.04: CON2.8, U4.G4 (P1.04)
/P1.05: CON2.9, U4.E9 (P1.05)
/P1.06: CON2.10, U4.G1 (P1.06)
/P1.07: CON2.11, U4.F7 (P1.07)
/P1.08: CON2.12, U4.G5 (P1.08)
/P1.09: U2.15 (SCL), U3.1 (SCL), U4.G7 (P1.09)
/P1.10: U2.16 (SDA), U3.8 (SDA), U4.J7 (P1.10)
/P1.11: U3.2 (ALERT), U4.H9 (P1.11)
/P1.12: R25.2, U4.G8 (P1.12)
/P1.13: CON1.12, U4.G9 (P1.13)
/P1.14: R27.2, U4.F8 (P1.14)
/P1.15: R26.2, U4.F9 (P1.15)
/PGOOD: R24.2, U2.11 (IO6), U7.14 (PGOOD)
/PSEN: R18.1, U2.10 (IO5), U7.12 (EN)
/PSMODE: R17.1, U2.9 (IO4), U7.13 (PS/SYNC)
/QSPI-CSN: CON4.5, U4.E1 (P0.18/CSN)
/QSPI-IO0: CON4.6, U4.D2 (P0.13/IO0)
/QSPI-IO1: CON4.7, U4.E2 (P0.14/IO1)
/QSPI-IO2: CON4.8, U4.D1 (P0.15/IO2)
/QSPI-IO3: CON4.11, U4.F2 (P0.16/IO3)
/QSPI-SCK: CON4.4, U4.F1 (P0.17/SCK)
/RESET: C1.1, D1.2 (A), J2.5, R6.2, SW1.1 (A), SW1.2 (B), U2.13 (~RESET), U4.J3 (~RESET)
/RxD: J2.3, U4.C8 (P0.22)
/SCL: CON2.4, U4.A3 (P1.03/TWI)
/SDA: CON2.5, U4.B4 (P1.02/TWI)
/SPI-CS: CON3.5, U4.B3 (P0.11/TRACEDATA0/CSN)
/SPI-DCX: CON3.8, U4.A2 (P0.12/TRACECLK/DCX)
/SPI-MISO: CON3.6, U4.C1 (P0.10/TRACEDATA1/MISO)
/SPI-MOSI: CON3.7, U4.C2 (P0.09/TRACEDATA2/MOSI)
/SPI-SCK: CON3.4, U4.B1 (P0.08/TRACEDATA3/SCK)
/SWDCLK: J2.6, U4.J2 (SWDCLK)
/SWDIO: J2.7, U4.H2 (SWDIO)
/SYS: C11.1, C13.1, R18.2, U6.2 (VOUT), U6.7 (VOUT), U7.10 (VIN), U7.11 (VIN__1)
/TxD: J2.2, U4.A5 (P0.20)
/USER: R29.2, SW2.1 (A), SW2.2 (B), U4.D7 (P0.23)
/VBAT: C10.1, J3.1, R5.1, U5.3 (V_{BAT}), U6.6 (VIN2)
/VBATMON: R1.1, R5.2, U1.5 (X5)
/VBUS: C5.1, C9.1, D2.4 (VCC), D5.2 (A), J1.A4 (VBUS), J1.A9 (VBUS), J1.B4 (VBUS), J1.B9 (VBUS), R7.1, R19.1, U5.4 (V_{DD}), U6.3 (VIN1), U6.5 (MODE)
/VBUSMON: R7.2, R8.1, U1.1 (X4)
/VINA: C12.1, U7.1 (VINA)
/XL1: C8.1, U4.C6 (P0.00/XL1), Y1.2
/XL2: C7.1, U4.B6 (P0.01/XL2), Y1.1
GND: C1.2, C2.2, C3.2, C4.2, C5.2, C6.2, C7.2, C8.2, C9.2, C10.2, C11.2, C12.2, C13.2, C14.2, C15.2, C16.2, CON1.1, CON1.MP1, CON1.MP2, CON1.MP3, CON1.MP4, CON2.1, CON2.MP1, CON2.MP2, CON2.MP3, CON2.MP4, CON3.1, CON3.MP1, CON3.MP2, CON3.MP3, CON3.MP4, CON4.1, CON4.MP1, CON4.MP2, CON4.MP3, CON4.MP4, D2.1 (GND), J1.A1 (GND), J1.A12 (GND), J1.B1 (GND), J1.B12 (GND), J1.S1 (SHIELD), J2.8, J2.MP (MountPin), J3.2, Q1.2 (S), R1.2, R2.2, R4.2, R8.2, R10.1, R11.1, R12.2, R13.2, R14.2, R15.2, R16.2, R17.2, R20.2, R21.2, SW1.3 (A), SW1.4 (B), SW2.3 (A), SW2.4 (B), U1.6 (Inh), U1.7 (VEE), U1.8 (VSS), U2.1 (A0), U2.2 (A1), U2.3 (A2), U2.6 (VSS), U3.3 (ADR0), U3.6 (ADR1), U3.7 (GND), U4.A1 (VSS), U4.A9 (VSS), U4.B2 (VSS), U4.B8 (VSS), U4.E4 (VSS), U4.E5 (VSS), U4.F4 (VSS), U4.F5 (VSS), U4.K2 (VSS), U4.K3 (VSS), U4.K5 (VSS), U4.K7 (VSS), U4.K8 (VSS), U4.L1 (VSS), U4.L9 (VSS), U4.M1 (VSS), U4.M2 (VSS), U4.M8 (VSS), U4.M9 (VSS), U5.2 (V_{SS}), U6.1 (GND), U7.2 (GND), U7.15 (PGND)
unnamed: D3.2 (A), R23.1
unnamed: D3.1 (K), Q1.3 (D)
unnamed: D4.2 (BK), R25.1
unnamed: D4.3 (GK), R27.1
unnamed: D4.4 (RK), R26.1
unnamed: D5.1 (K), R28.2
unnamed: J1.A5 (CC1), R3.1, R10.2
unnamed: J1.B5 (CC2), R9.1, R11.2
unnamed: U1.3 (X), U3.4 (VIN)
unnamed: TP1.1, U2.12 (IO7)
unnamed: R20.1, U5.5 (PROG)
unnamed: R28.1, U5.1 (STAT)
unnamed: R16.1, R19.2, U6.4 (PR1)
