lawrencek52/CPU1-NRF5340-uBlox-NORA/(commit log)

2025-08-28 first save of project
    [CPU1-NRF5340-uBlox-NORA.csv, CPU1-NRF5340-uBlox-NORA.kicad_pcb, CPU1-NRF5340-uBlox-NORA.xlsx, bom.csv, designators.csv, positions.csv]
2025-09-19 files after sent to Bittele, with corrections for Bittele
    [Bittele_Initial_DFA_Check_Report_8030233A1_2025-09-05_LJK.xlsx, Bittele_Initial_DFM_Check_Report_8030233A1_20250904_LJK.xlsx, Bittele_Initial_DFM_Check_Report_8030233A1_20250905(2nd)_LJK.xlsx, Bittele_Initial_DFM_Check_Report_8030233A1_20250911(3rd)_LJK.xlsx, CPU1-7PCB.xls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]
